Vladi2017/OrCAD_PSpice_1/project_doc/projectDoc_VoltageRegulator_2.pdf

### Cuprins

1. Tema proiectului.

Proiectarea si simularea (OrCAD) unui stabilizator de tensiune cu parametrii Vin = 10 - 15V (amplitudinea variabila a semnalului de intrare); Vout (amplitudinea stabilizata a semnalului de ieșire) = 10V; Ps = 3W (puterea pe rezistenta de sarcina); Precizie = 5%.

1.1. Aspecte specifice.
Din cerințele temei de proiect se observă că avem constrângerea vI,min ≈ vO. Din acest considerent:
- s-a evitat implementarea unei scheme cu element de reglare paralel (datorită căderii de tensiune pe rezistența de balast).
- nu s-a adoptat soluția cu element regulator serie de tip NPN (pe borna + a ieșirii), evitându-se astfel căderea de tensiune BE (care la tranzistoarele de medie putere poate fi 0.75V ÷ 0.9V). Întrucât nu putem avea o cădere nulă de tensiune pe stabilizator (ceea ce ar presupune un randament de 100% al acestuia), pentru domeniul vI,min s-a urmărit încadrarea în precizia de 5% admisă de tema de proiect. Prin urmare se propune schema de stabilizator de tensiune prezentată la pg. 2 fig.1. cu regulator serie de tip PNP.
Ca o primă observație importantă trebuie remarcat că în zona vI,min regulatorul serie PNP va funcționa în regim de saturație unde ne așteptăm la căderi vCE1 de 0.2 ÷ 0.3V, deci aparent ne putem încadra în precizia de 5% [9.5 ÷ 10.5]V.

### Manolescu Vladimir / May 2022 / mvmanol@yahoo.com

2. Prezentarea principiului de funcționare.

Schema OrCAD este prezentată la pg.2 fig.1: Stabilizator liniar cu reacție de tip amplificator de eroare, cu regulator serie.
Tranzistorul Q1 are rol de element regulator serie. Amplificatorul de eroare (de tip transconductanță) este bazat pe tranzistoarele Q3 și Q2. De remarcat că în amplificatorul de eroare s-au folosit 2 tranzistoare NPN astfel încât faza reacției să compenseze efectele ”perturbației” (variația vI respectiv iO) asupra tensiunii de ieșire vO.
Dioda Zener lucrează în zona de străpungere astfel încât vZ are o valoare aproximativ constantă, egală cu tensiunea nominală de străpungere a diodei Vz (parametru de catalog). Rz are rol de polarizare a diodei Zener. Se va alege i[Rz] >> iC2 astfel încât i[Rz] ≈ iZ. Astfel variațiile curentului iC2 nu vor afecta semnificativ vZ.
Cu ajutorul semireglabilului P se va fixa tensiunea la ieșirea stabilizatorului. Pentru a ataca în tensiune intrarea reacției (vB3), curentul prin divizorul rezistiv (iD) trebuie să fie >> iB3.
Funcționarea schemei: pentru tensiunea VO = 10V fixată din semireglabilul P, tranzistorul regulator serie Q1 anulează tendințele de variație ale tensiunii vO atunci când vI sau iO variază. Cum vI = vCE1 + vO, avem:
- când vI crește sau iO scade tendința va fi ca vO să crească. Aceasta implică succesiv: vB3 ↗ => vBE3 ↗ => iC3 ↗ => iB2 ↘ => iC2 ↘ => iB1 ↘ => vCE1 ↗ => vO →. Se observă că regulatorul serie preia tendința de

creștere vO.

- când vI scade sau iO crește tendința va fi ca vO să scadă, cu următoarele consecințe: vB3 ↘ => vBE3 ↘ => iC3 ↘ => iB2 ↗ => iC2 ↗ => iB1 ↗ => vCE1 ↘ => vO →. Se observă din nou că regulatorul serie compensează

tendința de scădere vO pe sarcină.
3. Schema OrCAD (fără protecție la scurtcircuit).

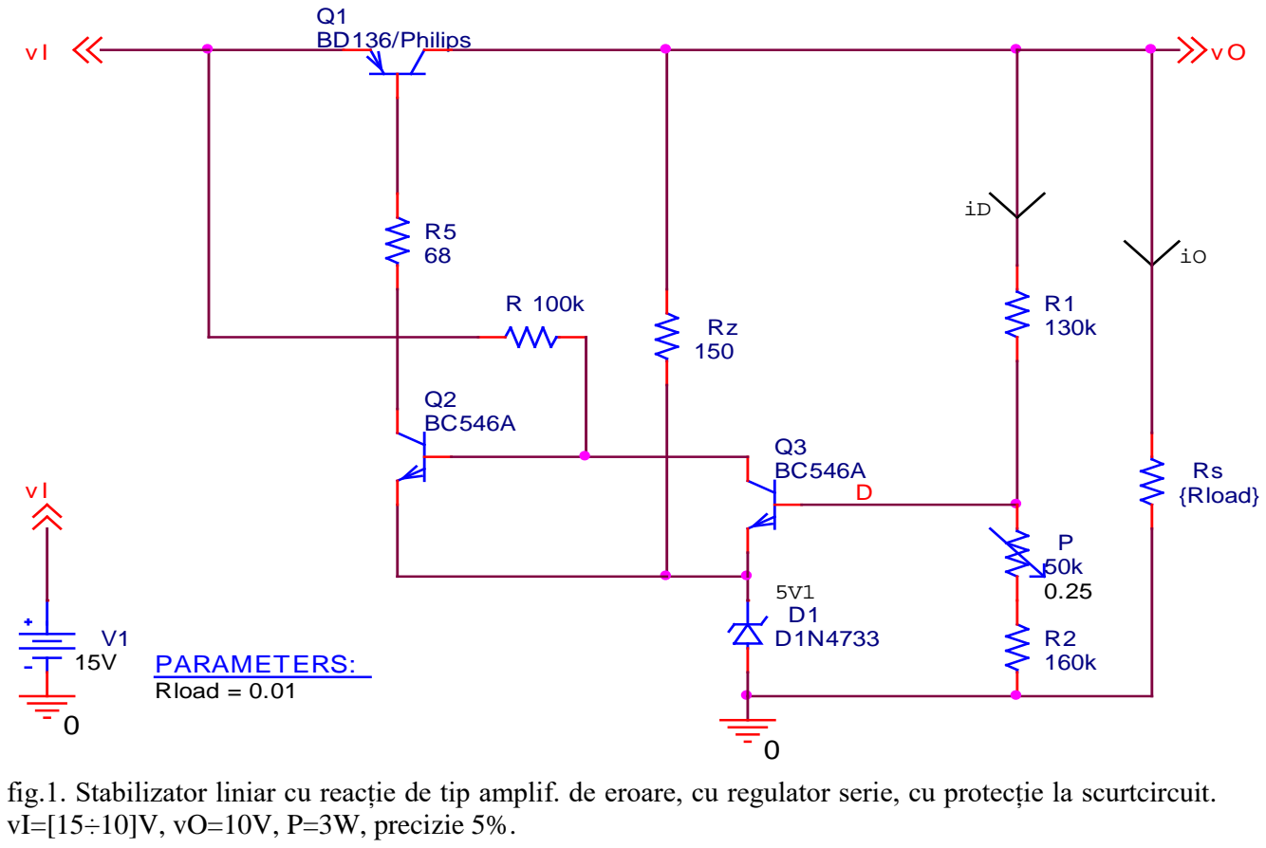
[picture p1: figure]
vI=[15÷10]V, vO=10V, P=3W, precizie 5%.; PARAMETERS:; Rload = 0.01; Rs {Rload}; Q1 BD136/Philips

fig.1. Stabilizator liniar cu reacție de tip amplif. de eroare, cu regulator serie, cu protecție la scurtcircuit.

3.1. Elemente de proiectare.

Din datele de proiect rezultă:

# iO,max = P

vO

= 3
10 => iO,max = 300mA.

vO = VO ± 5% => vO = [9.5 ÷ 10.5]V.
Puterea maximă sustenabilă pe regulatorul Q1 este:

PQ1,max = vCE1,maxiC1,max = vI,max − vO,miniO,max = (15 − 9.5)0.3 = 1.65W.

Se alege ca regulator serie tranzistorul Q1 pnp BD136,cu puterea maximă admisă Pmax = 12.5W și IC1,max = 1.5A. Nu vom impune montarea acestuia pe radiator (admițându-se că va exista o ventilare naturală). Adăugăm următoarele date: β1=50, VBE1=0.8V, β2=200, β3=50 (va lucra cu VCE3 ≈ 0.65V respectiv iC3 de ordinul μA), vBE2 = vBE3 = 0.65V, R5 = 68ohm (stabilizează funcționarea în temperatură).
Determinarea rezistenței R: iR va fi partajat de iB2 și iC2, curenți prin care se asigură mecanismul de reacție pentru stabilizarea tensiunii vO.

# R = vi,min − vBE2 − Vz

iB2
și trebuie să impunem iB2 = iO,max

# β1β2 , => R = vi,min−vBE2−Vz

# iO,max

β1β2 = 10−0.65−5.1

0.3 ∙ 50 ∙ 200 ≈ 140kΩ

Alegem R=100kΩ/250mW, valoare standardizată.
Valoarea Rz a rezistenței de polarizare a diodei Zener: condiția este ca Iz >> iC2 pentru ca dioda Zener să rămână în zona de stabilizare. => IZ ≫ iO,max

# β1 = 5∙iO,max

β1
Rezultă: Rz = vO−Vz

# 5∙iO,max

β1 = 10−5.1

5∙0.3 ∙ 50 = 163Ω.

Se alege valoarea standardizată Rz=150Ω/250mW.
Calculul divizorului rezistiv R1, P, R2: Pentru a obține tensiunea de la intrarea reacției transconductanță, condiția este: iD >> iB3 => iD = 50 ∙ iB3 = 50∙iO,max

# β1β2β3

=>

# R1 + P + R2 = vO

# 50∙iO,max

# β1β2β3 = 10

50∙0.3 ∙ 50 ∙ 200 ∙ 50 ≈ 333kΩ.
Din schemă rezultă: vD = Vz + vBE3 = R2+P

# R1+R2+P

vO

Ca observație, din relația de mai sus rezultă că în condiții normale de funcționare (regulatorul Q1 în

RAN), tensiunea de ieșire vO depinde exclusiv de Vz + vBE3 = constant și de raportul (R1+R2+P)/(R2+P).

Prin urmare putem alege convenabil valorile pe divizorul rezistiv impunând vO = 10V și evident menținând condiția iD >> iB3:

# => R2 + P = (Vz+vBE3)(R1+R2+P)

vO

= (5.1+0.65)∙333k

# 10 => R2 + P ≈ 192kΩ

ð R1 = R1 + P + R2 − P − R2 ≈ 142kΩ. Alegem valoarea standard R1=130kΩ/0.25W.
De asemenea pentru R2 + P ≈ 192kΩ vom avea valorile standard: R2=160kΩ/0.25W și respectiv

semireglabilul P=50kΩ/0.25W.

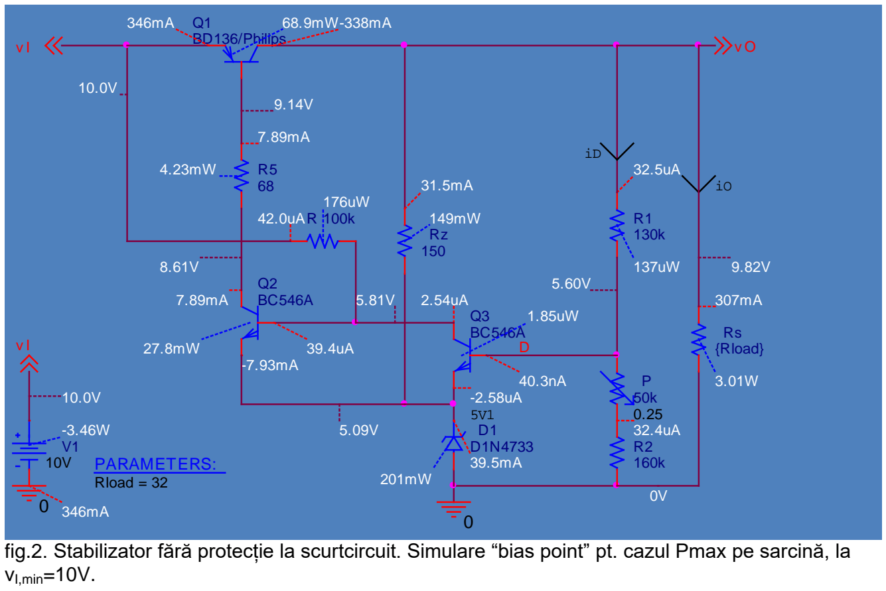
[picture p2: figure]
vI,min=10V.; PARAMETERS: Rload = 32; Q1 BD136/Philips; Rs {Rload}

fig.2. Stabilizator fără protecție la scurtcircuit. Simulare “bias point” pt. cazul Pmax pe sarcină, la

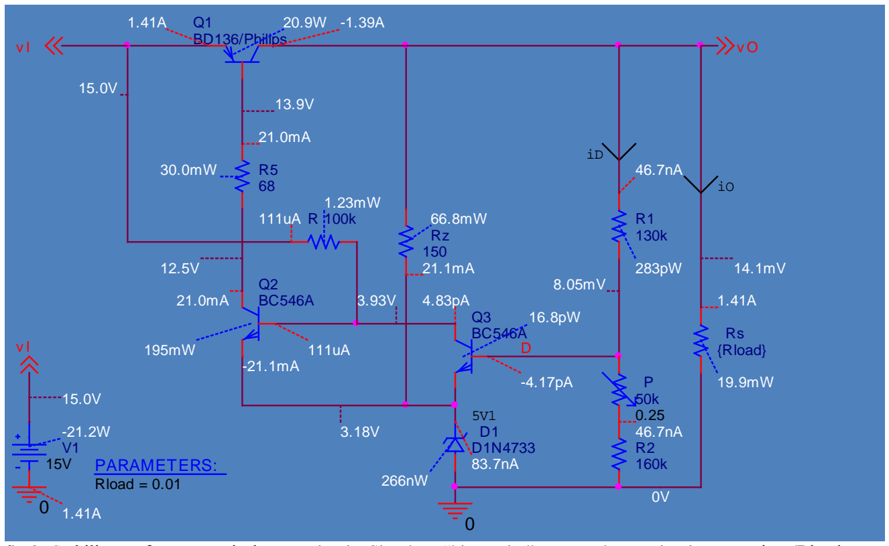
[picture p3: figure]
PARAMETERS: Rload = 0.01; Rs {Rload}; Q1 BD136/Philips

fig.3. Stabilizator fără protecție la scurtcircuit. Simulare “bias point” pt. cazul scurtcircuit pe sarcină (Rload = 0.01), la vI,max=15V. Se observă că întreaga putere este preluată de regulatorul Q1 (cu datele de catalog IcMax = 1.5A, Pmax = 12W), tranzistor care în acest caz se va distruge. Măsurătorile de mai sus (în special puterea pe Q1) se vor compara cu cazul în care schemei i se adaugă protecția la scurtcircuit (a se vedea pg.10, fig.8).

3.2. Performanțe. Aspecte teoretice.
Pentru a evalua performanțele stabilizatorului de tensiune, facem o scurtă prezentare a acestora. Tensiunea de ieșire vO depinde de tensiunea de intrare vI, curentul iO consumat de sarcina Rs și de temperatura de funcționare. Vom studia prin simulare PSpice influența vI și iO asupra vO, deci vom studia funcția vO=vO(vI, iO). Această funcție se poate diferenția și se obține:

# dvO = ∂vO

∂vI

# dvI +

∂vO
∂iO

# diO

În practică, pentru variații vI și iO în domeniul de funcționare normal al stabilizatorului, se poate scrie:

∆vO = 1
S

# ∆vI − Ro∆iO, unde: S ≝ ∆vI

∆vO

|∆iO = 0 este coeficientul de stabilizare.

# Ro ≝ ∆vO

−∆iO

|∆vI = 0 este rezistența de ieșire.

Se poate defini și un coeficient de stabilizare în sarcină pentru un RL de valoare finită. Astfel, în schema echivalentă de semnal mic a stabilizatorului de tensiune, curentul de ieșire iO va fi nenul și va depinde de RL. Conform fig.4 de mai jos se obține:

# vo = RL RL + Ro

∙

vI
S

Notând factorul de stabilizare în sarcină cu K, rezultă:

K ≝

vI
vO

# |RL = finit = (1 +

Ro
RL

) ∙ S.

Se observă că pentru RL → ∞, se obține K = S. Un stabilizator de tensiune performant are rezistența de ieșire Ro foarte mică, astfel încât Ro << RL, caz în care K ≈ S.

fig.4

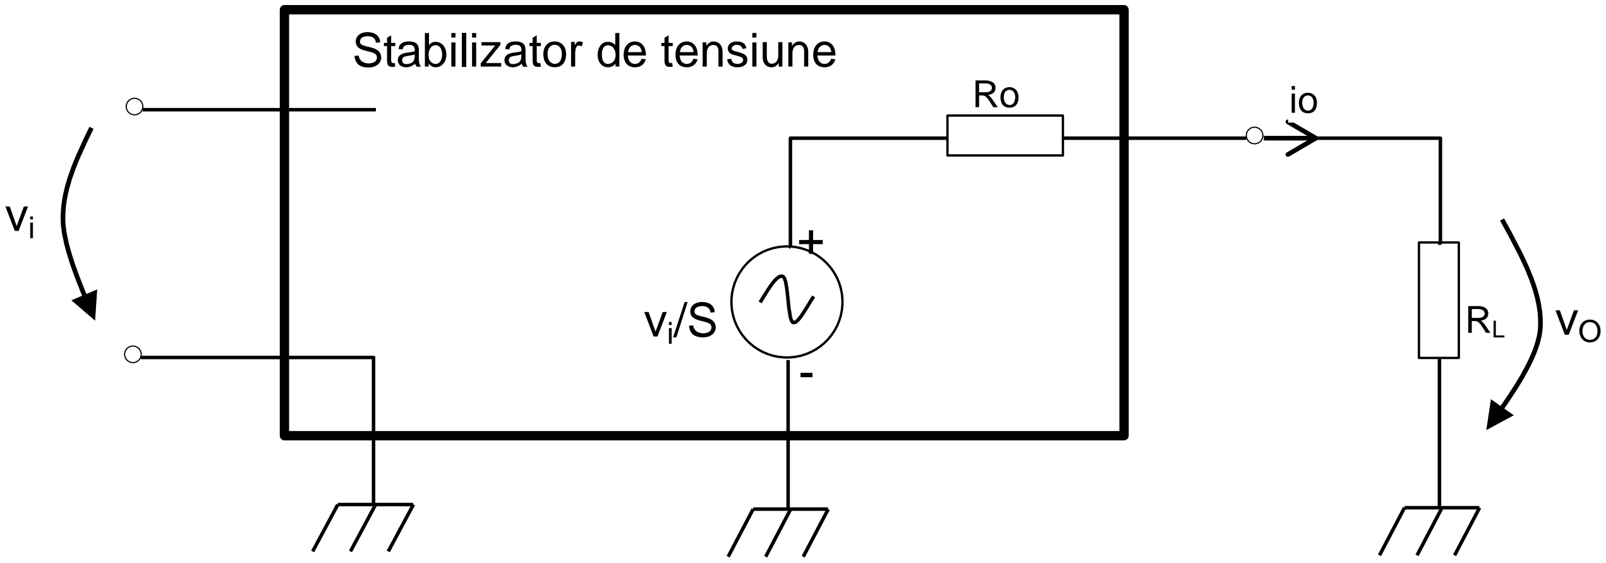
[picture p4: figure]
Stabilizator de tensiune

În continuare vom face un studiu PSpice al parametrilor de performanță S și Ro, respectiv variația acestora în domeniul temei de proiect: vI=[10 ÷ 15]V, respectiv Po=[1 ÷ 3]W ce corespunde unui curent de ieșire iO=[0.1 ÷ 0.3]A.
Pentru studiul S și Ro se va folosi funcția PSpice D(x) – (numerical) derivative.

3.3. Coeficientul de stabilizare (simulare PSpice).
Pentru schema din fig.1, variația coeficientului de stabilizare K (în sarcină) funcție de vI este prezentată la pg. 7, fig.5, împreună cu alte elemente relevante (tensiunea și puterea pe sarcină).

Observație: se poate pune întrebarea de ce factorul de stabilizare K nu este constant, întrebare de altfel plauzibilă și pentru cazul rezistențelor de ieșire Ro (tratate în paragraful 5). Explicația este aceea că în graficele următoare nu se fac analize de semnal mic. Așa cum se precizează mai sus, pentru K avem variații vI pe intrare de 5V, respectiv pentru Ro avem o variație de curent prin sarcină de cca. 200mA. Practic stabilizatorul (prin analize de tip DC-sweep) este tranzitat prin puncte statice de funcționare succesive unde sunt calculate derivatele numerice pentru aproximarea K respectiv Ro. Analiza se face în întreg domeniul solicitat de tema de proiect.

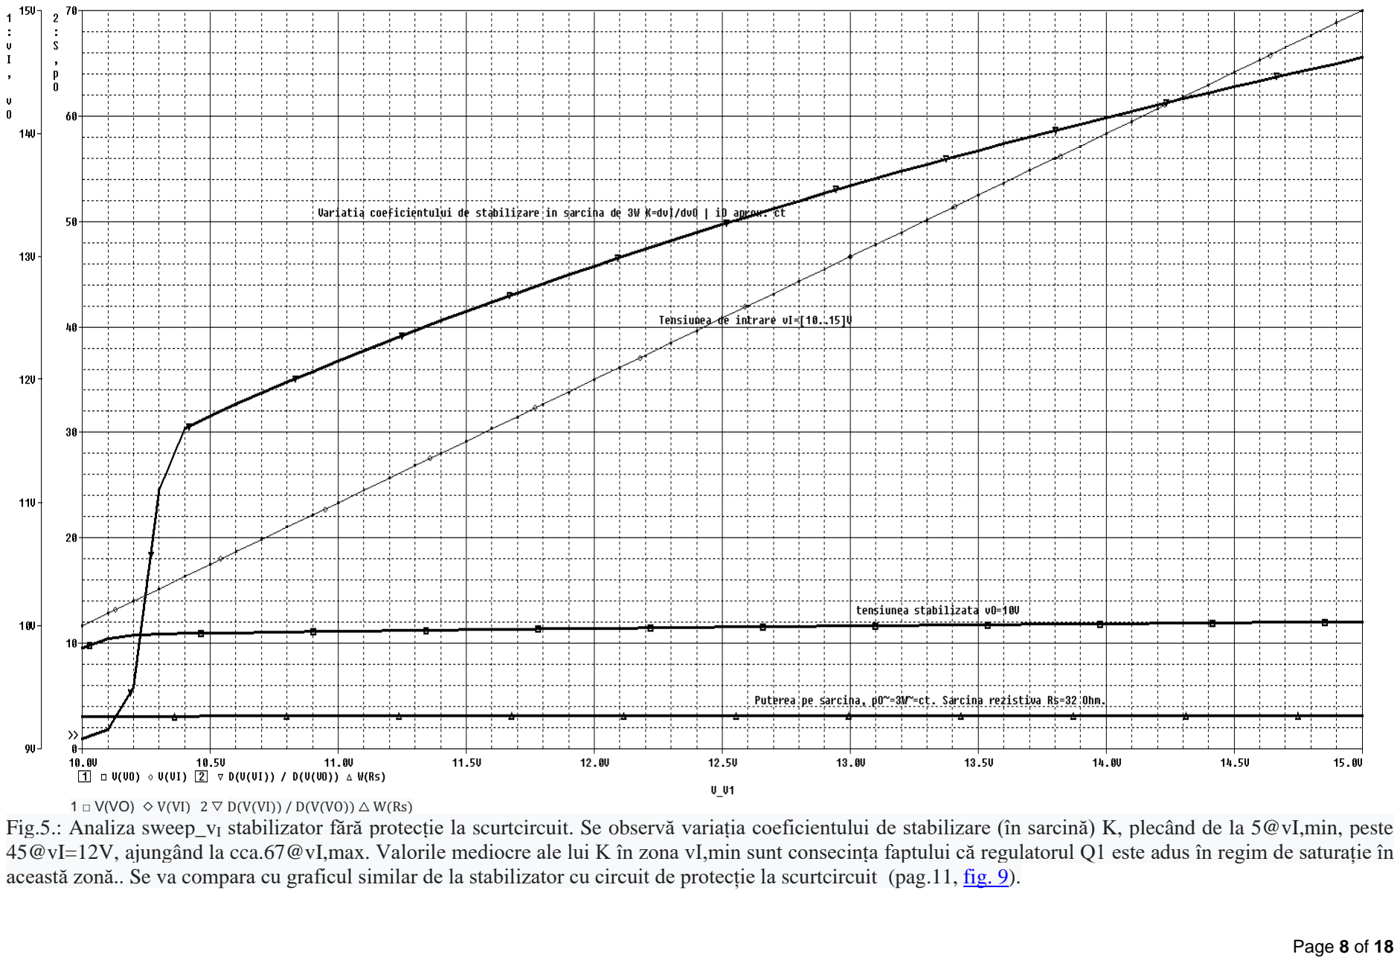
[picture p5: page 7]

# 1 □ V(VO) ◇ V(VI) 2 ▽ D(V(VI)) / D(V(VO)) △ W(Rs)

Fig.5.: Analiza sweep_vI stabilizator fără protecție la scurtcircuit. Se observă variația coeficientului de stabilizare (în sarcină) K, plecând de la 5@vI,min, peste 45@vI=12V, ajungând la cca.67@vI,max. Valorile mediocre ale lui K în zona vI,min sunt consecința faptului că regulatorul Q1 este adus în regim de saturație în această zonă.. Se va compara cu graficul similar de la stabilizator cu circuit de protecție la scurtcircuit (pag.11, fig. 9).

4. Schema OrCAd cu protecție la scurtcircuit.

Aceasta este prezentată în fig. 6 de mai jos și, după cum se observă, prezintă anumite elemente distinctive:
a. ”senzorul” de scurtcircuit (R6) este plasat înainte de regulatorul serie (uzual acesta este plasat după regulator). În acest mod, R6 (combinat și cu valoarea redusă a rezistenței acestuia) are o influență mai redusă asupra rezistenței de ieșire Ro a stabilizatorului.
b. căderea de tensiune pe R6 este ”citită” de o combinație de tranzistoare în configurație Darlington.
c. circuitul de protecție nu mai atacă (direct) baza regulatorului serie (metoda uzuală), ci atacă intrarea amplificatorului de eroare, speculând amplificarea acestuia. S-a introdus R7 astfel încât traseul să nu fie compus din secțiuni exclusiv semiconductoare.
Combinația elementelor prezentate mai sus ne permite să micșorăm valoarea rezistenței R6 fără a compromite funcționalitatea montajului. O rezistență R6 de valoare cât mai mică are efect benefic asupra impedanței de ieșire Ro cât și (în cazul nostru particular) asupra coeficientului de stabilizare în zona vI,min. Deși nu se exploatează întreg potențialul configurației Darlington (întrucât prin circuitul de protecție avem curenți de valoare foarte mică), totuși protecția se activează la o cădere de tensiune de cca. 0.4V pe R6. Dezavantajul schemei de protecție prezentate este că nu permite LED indicator de scurtcircuit (suprasarcină), curentul maxim iC5 fiind de cca. 19uA.

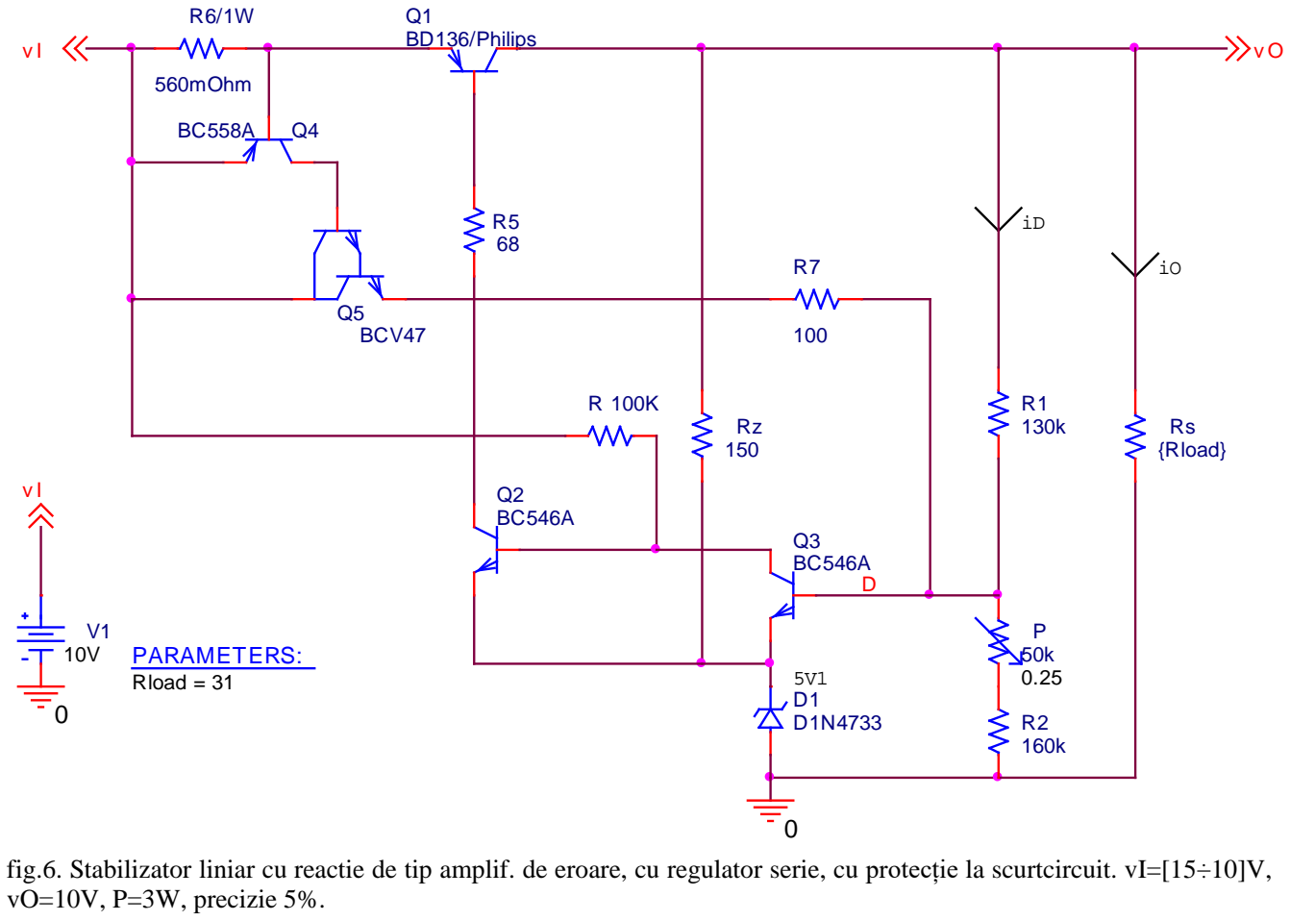
[picture p6: figure]
vO=10V, P=3W, precizie 5%.; PARAMETERS: Rload = 31; Q1 BD136/Philips vI; 560mOhm; Q5 BCV47; Rs {Rload}

fig.6. Stabilizator liniar cu reactie de tip amplif. de eroare, cu regulator serie, cu protecție la scurtcircuit. vI=[15÷10]V,

4.1. Principiul de funcționare al circuitului de protecție.
La activare (atingerea unui curent iC1 de cca 650mA), circuitul de protecție ”trage în sus” potențialul vB3, consecința finală fiind reducerea iB1 și respectiv limitarea iC1. Reacția de amplificare transconductanță este practic atacată în tensiune, curentul iC5,max fiind de cca. 19uA (a se vedea fig.8).

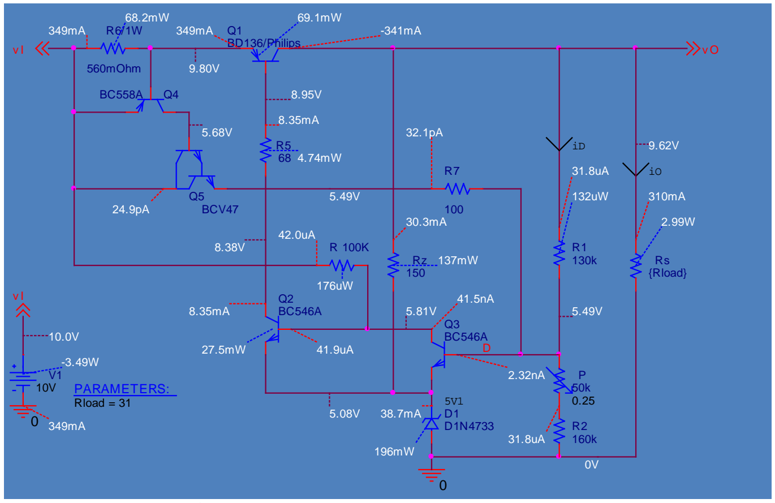
[picture p7: figure]
Q1 BD136/Philips; PARAMETERS: Rload = 31; BCV47; Rs {Rload}; 560mOhm

Fig.7. Stabilizator cu protecție la scurtcircuit. Simulare “bias point” pt. cazul Pmax pe sarcină.
Comparativ cu schema fără protecție (fig.2, pag.4) observăm o degradare cu 180mV (-1.84%) a tensiunii stabilizate, diferența regăsită pe rezistența de detecție scurtcircuit R6/1W. De asemenea remarcăm că pt. vI,min=10V, Q3 este practic blocat, curentul partajabil iR fiind preluat în totalitate pe iB2.

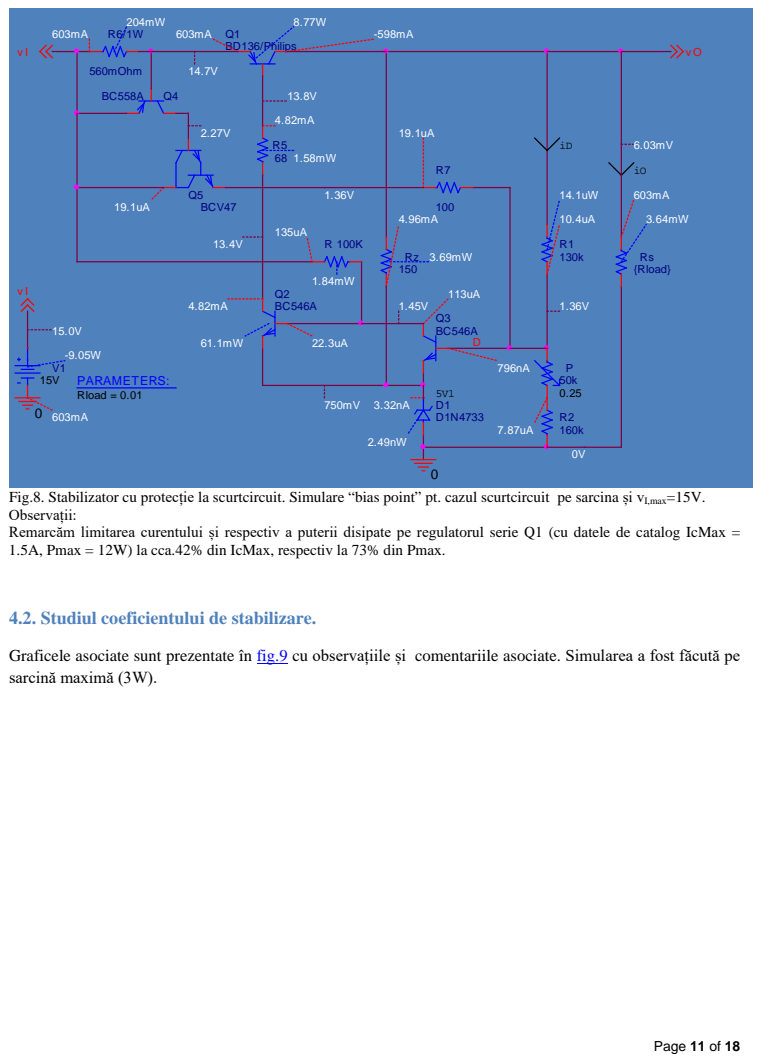
[picture p8: page 10]

Fig.8. Stabilizator cu protecție la scurtcircuit. Simulare “bias point” pt. cazul scurtcircuit pe sarcina și vI,max=15V.
Observații:
Remarcăm limitarea curentului și respectiv a puterii disipate pe regulatorul serie Q1 (cu datele de catalog IcMax =
1.5A, Pmax = 12W) la cca.42% din IcMax, respectiv la 73% din Pmax.

4.2. Studiul coeficientului de stabilizare.
Graficele asociate sunt prezentate în fig.9 cu observațiile și comentariile asociate. Simularea a fost făcută pe
sarcină maximă (3W).

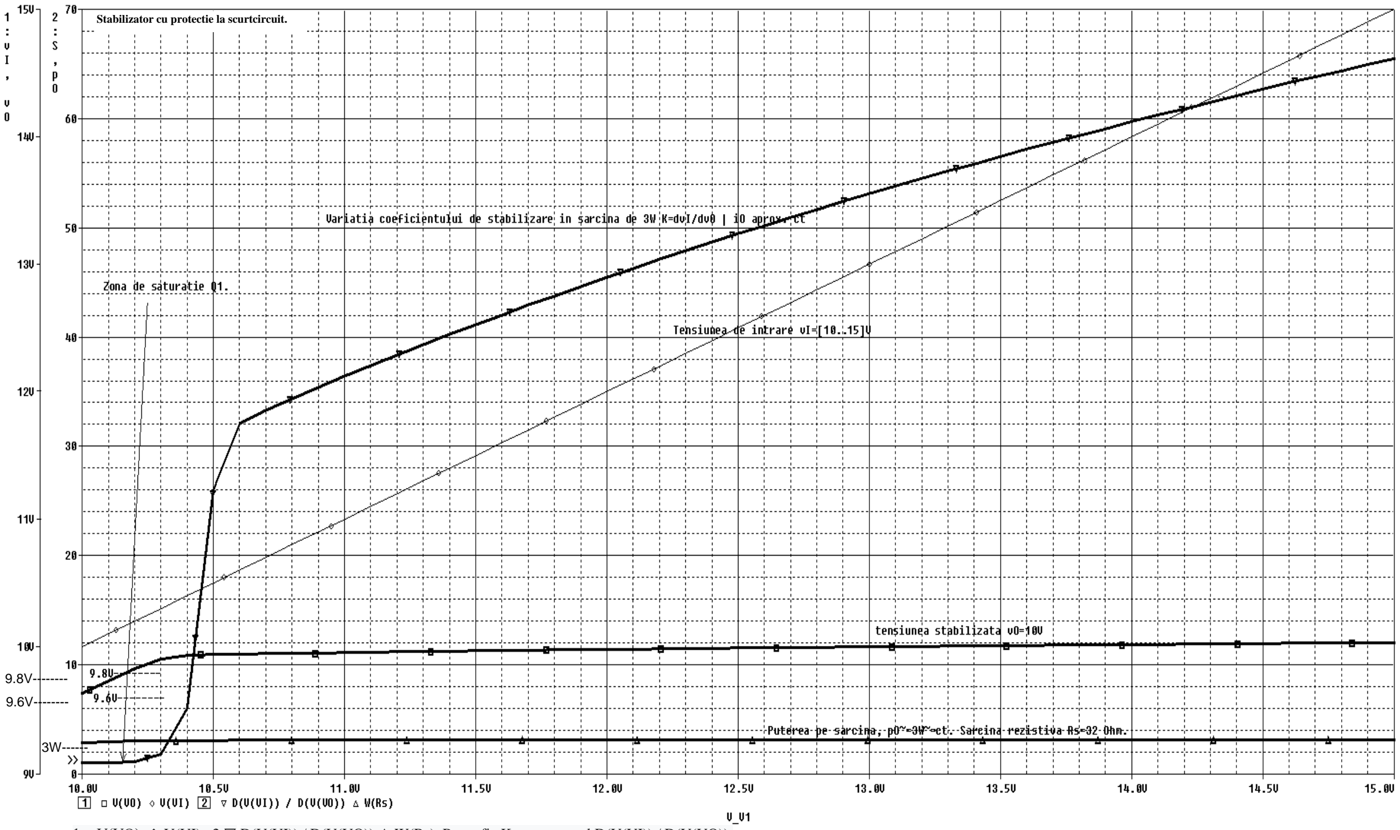
[picture p9: figure]

1 □ V(VO) ◇ V(VI) 2 ▽ D(V(VI)) / D(V(VO)) △ W(Rs). Pe grafic K este raportul D(V(VI)) / D(V(VO)).
Fig.9.: Analiza sweep_vI stabilizator cu circuit de protecție la sc. Se obs. degradarea pronunțată a coeficientului de stabilizare în sarcină (maximă). Avem K < 2 în zona vI,min, comparativ cu varianta fără circuit de protecție la sc (comparație cu graficul fig.5, pag.7). Practic zona de saturație Q1 se prelungește cu cca. 200mV, consecința influenței “senzorului” de sc R6. Cu alte cuvinte stabilizarea este relativ precară în zona vI,min [10..10.3]V, acesta fiind (parțial) prețul plătit pt. a avea protecție la scurtcircuit. R6 accentuează influența zonei de saturație a regulatorului Q1. În consecință deducem că “senzorul” R6 nu ar avea o influență semnificativă asupra lui K (coeficientului de stabilizare în sarcină) dacă stabilizatorul ar lucra cu vO < vI,min (aspect reliefat si de creșterea semnificativă a lui K după zona vI=10.4V). Pe de altă parte acest aspect (micșorarea zonei de saturație Q1) justifică soluția de protecție la scurtcircuit (configurație Darlington cu atacarea circuitului de reacție), aleasă tocmai în idea de a reduce cât mi mult valoarea ”senzorului” de suprasarcină R6.

Stabilizator cu protectie la scurtcircuit.

5. Grafice rezistențe de ieșire. Comparații.

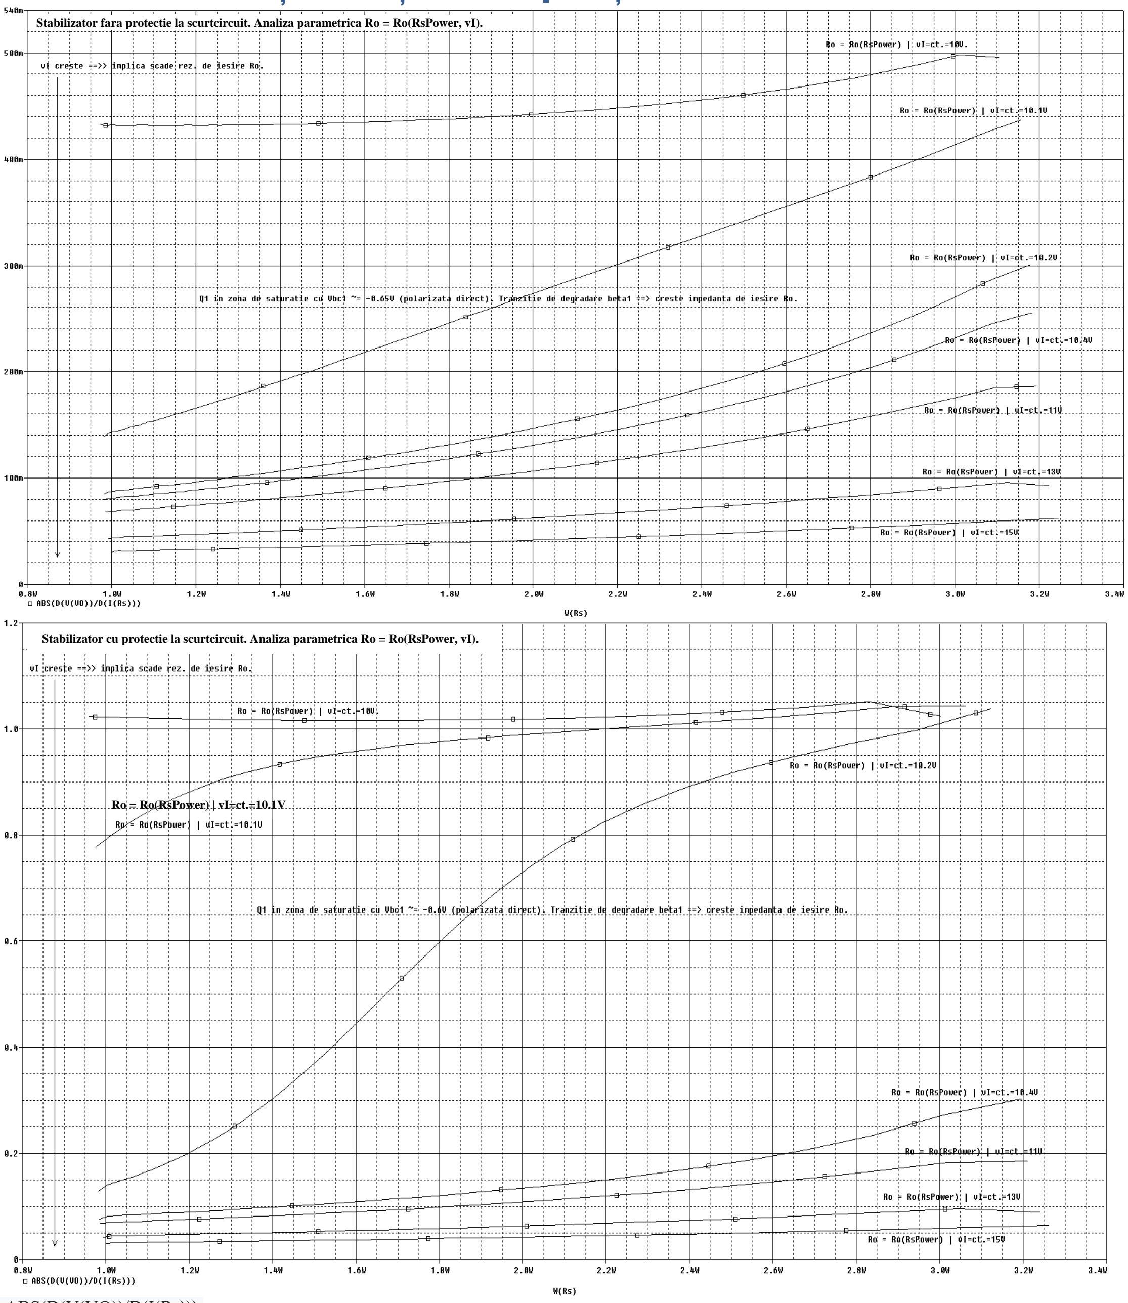
[picture p10: figure]
Ro = Ro(RsPower) | vI=ct.=10.1V

□ ABS(D(V(VO))/D(I(Rs))).
fig.10. Impedanțe de ieșire (Ro) – comparație pt. stabilizator fără / cu circuit de protecție la scurtcircuit. Se observă degradarea rezistenței de ieșire Ro comparativ cu cazul fără protecție la sc pt. cazul Q1 în zona de saturație (degradarea Ro este de la cca. 500mOhm la cca. 1.05 Ohm). Pt. cazul Q1 RAN degradarea Ro este mult mai redusă datorită configurației Q1 de bază comună cu ieșire din colector (”senzorul” de sc R6 fiind în emitor), cu valori cuprinse între 100mOhm ÷ 200mOhm. De asemenea observăm că pe măsură ce ne depărtăm de saturația Q1 (crește ecartul vi – vO, (deci crește vCE1), Ro scade și tinde să devină constantă în plaja de curent pe sarcină.

Stabilizator cu protectie la scurtcircuit. Analiza parametrica Ro = Ro(RsPower, vI).

Stabilizator fara protectie la scurtcircuit. Analiza parametrica Ro = Ro(RsPower, vI).

5.1. Analiza tensiunii stabilizate funcție de curentul prin sarcină. Aceasta este prezentată în fig.11 pentru cazul cu circuit de protecție la suprasarcină.

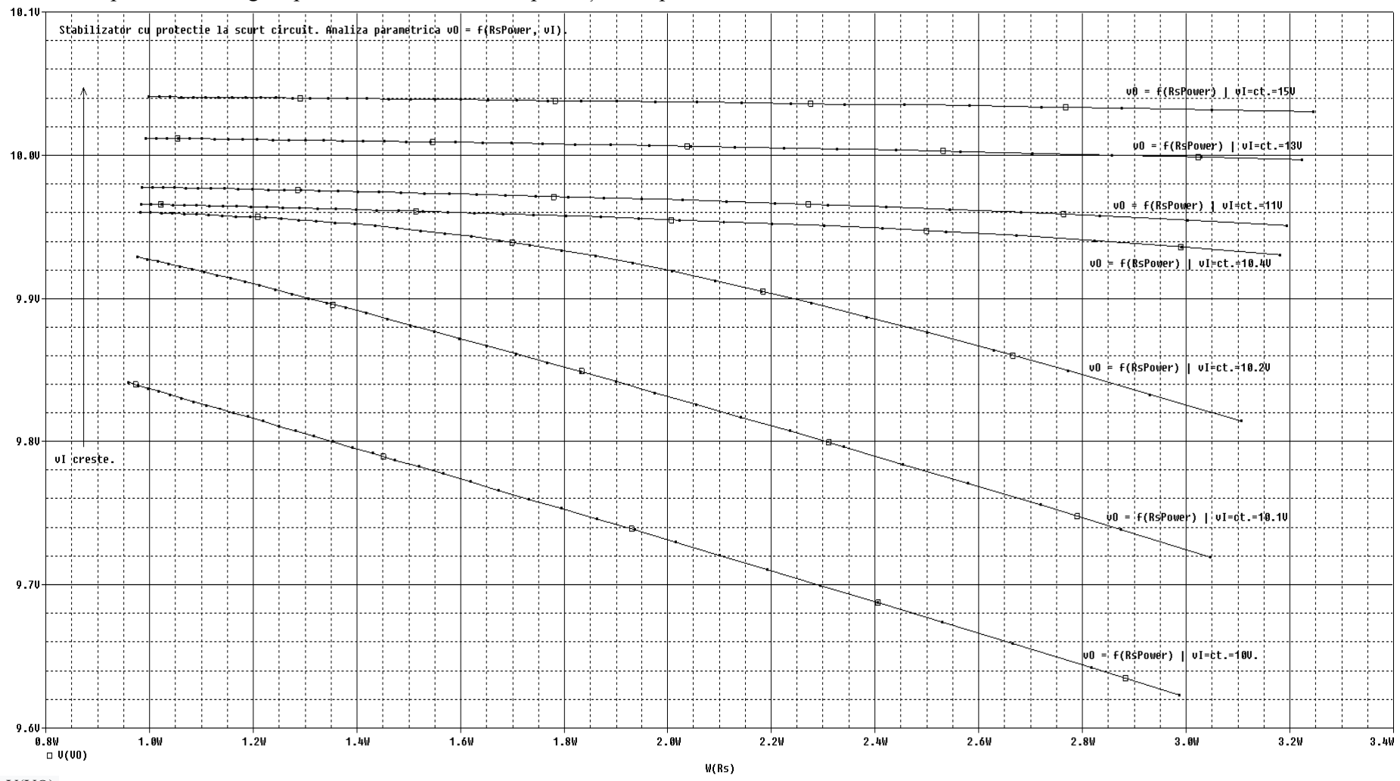
[picture p11: figure]

□ V(VO).
fig. 11. Arată consecințele rezistenței de ieșire Ro asupra vO și dependența Ro de vI. Ro scade (se îmbunătățește) cu cât crește ecartul vI-vO, permițând astfel regulatorului Q1 să lucreze în regiunea activă normală (RAN). Observație: din grafic, variațiile tensiunii stabilizate vO pot părea exagerate și aparent sursa nu ar stabiliza în sarcină. Cu toate acestea, dacă facem un calcul simplu, din grafic rezultă de ex. pt. cazul vI=10V≈vO (cazul cel mai defavorabil), că la o creștere a puterii pe sarcină cu 200% (de la 1W la 3W) avem o variație a tensiunii de ieșire vO de -2.23% (variație datorată evident rezistenței de ieșire Ro a sursei de tensiune).

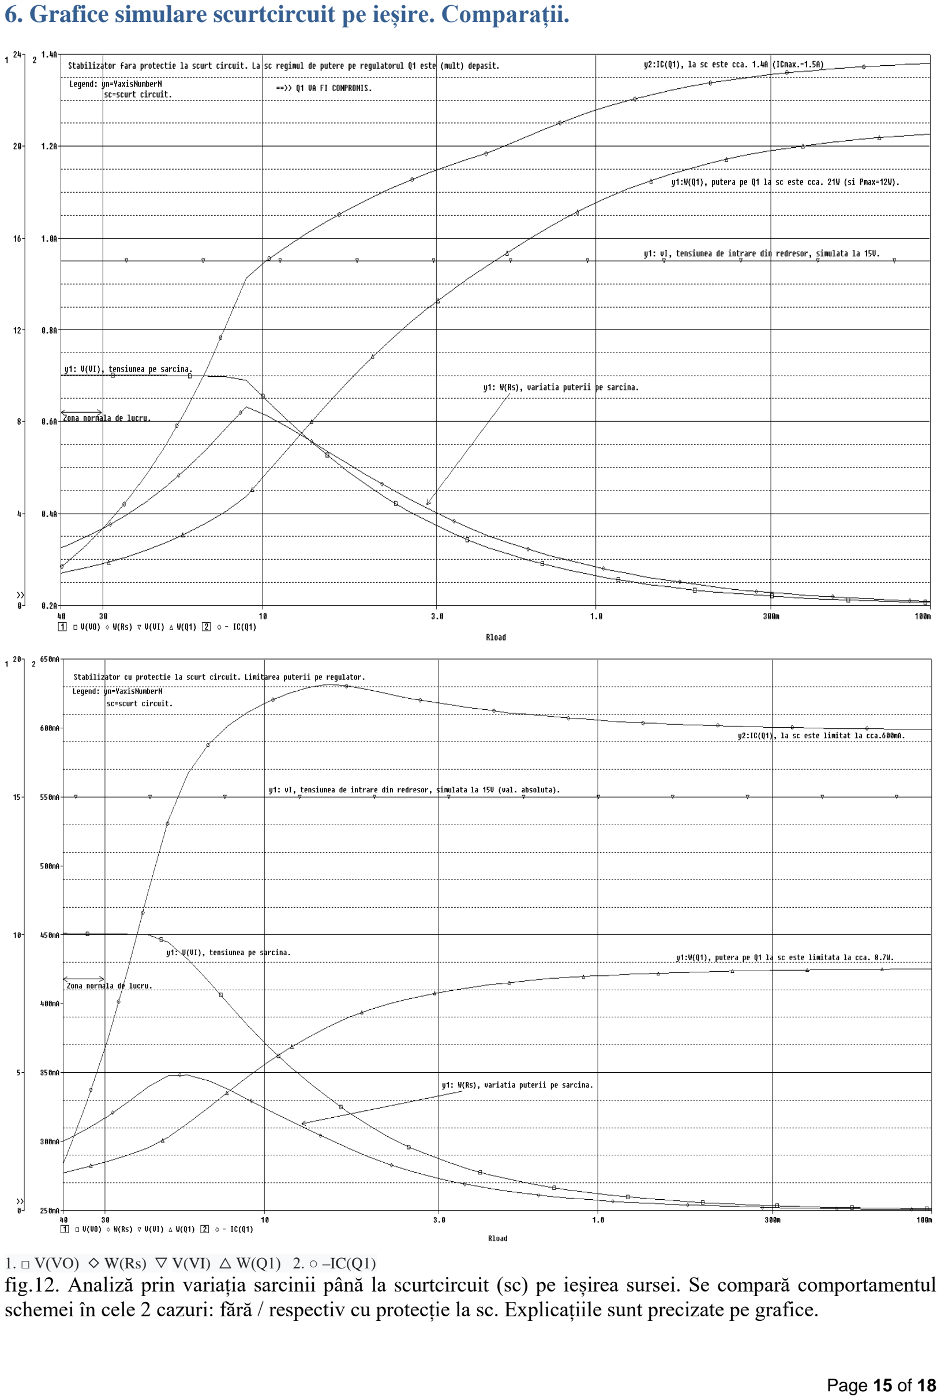
[picture p12: page 14]

6. Grafice simulare scurtcircuit pe ieșire. Comparații.
1. □ V(VO) ◇ W(Rs) ▽ V(VI) △ W(Q1) 2. ○ –IC(Q1)

fig.12. Analiză prin variația sarcinii până la scurtcircuit (sc) pe ieșirea sursei. Se compară comportamentul schemei în cele 2 cazuri: fără / respectiv cu protecție la sc. Explicațiile sunt precizate pe grafice.

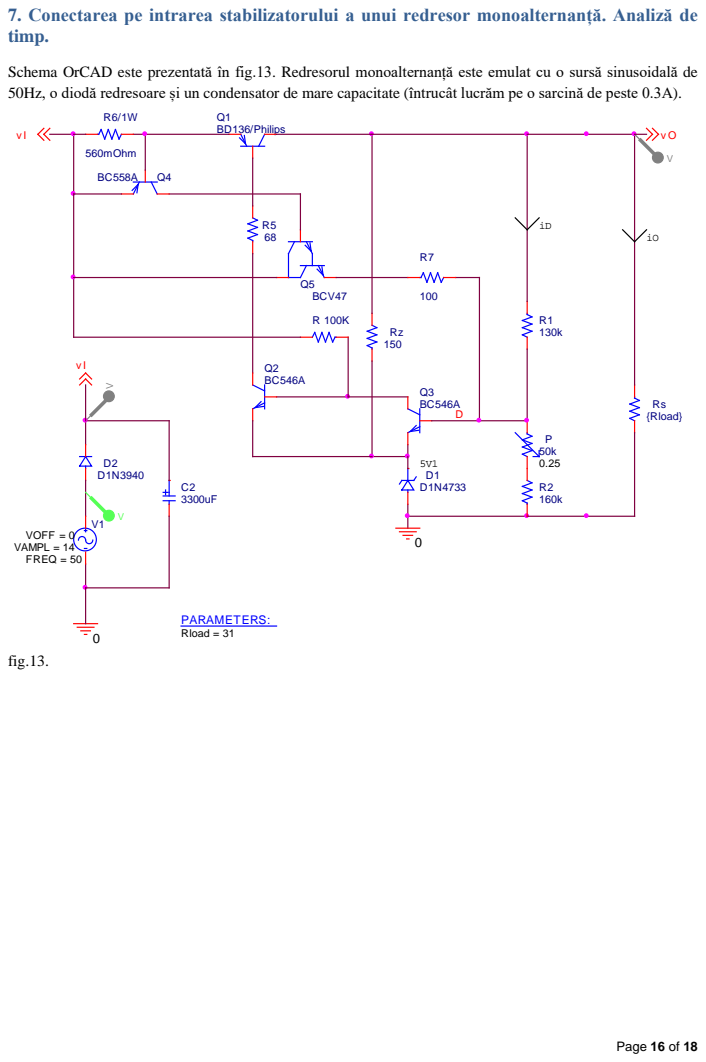
[picture p13: page 15]

7. Conectarea pe intrarea stabilizatorului a unui redresor monoalternanță. Analiză de
timp.
Schema OrCAD este prezentată în fig.13. Redresorul monoalternanță este emulat cu o sursă sinusoidală de
50Hz, o diodă redresoare și un condensator de mare capacitate (întrucât lucrăm pe o sarcină de peste 0.3A).

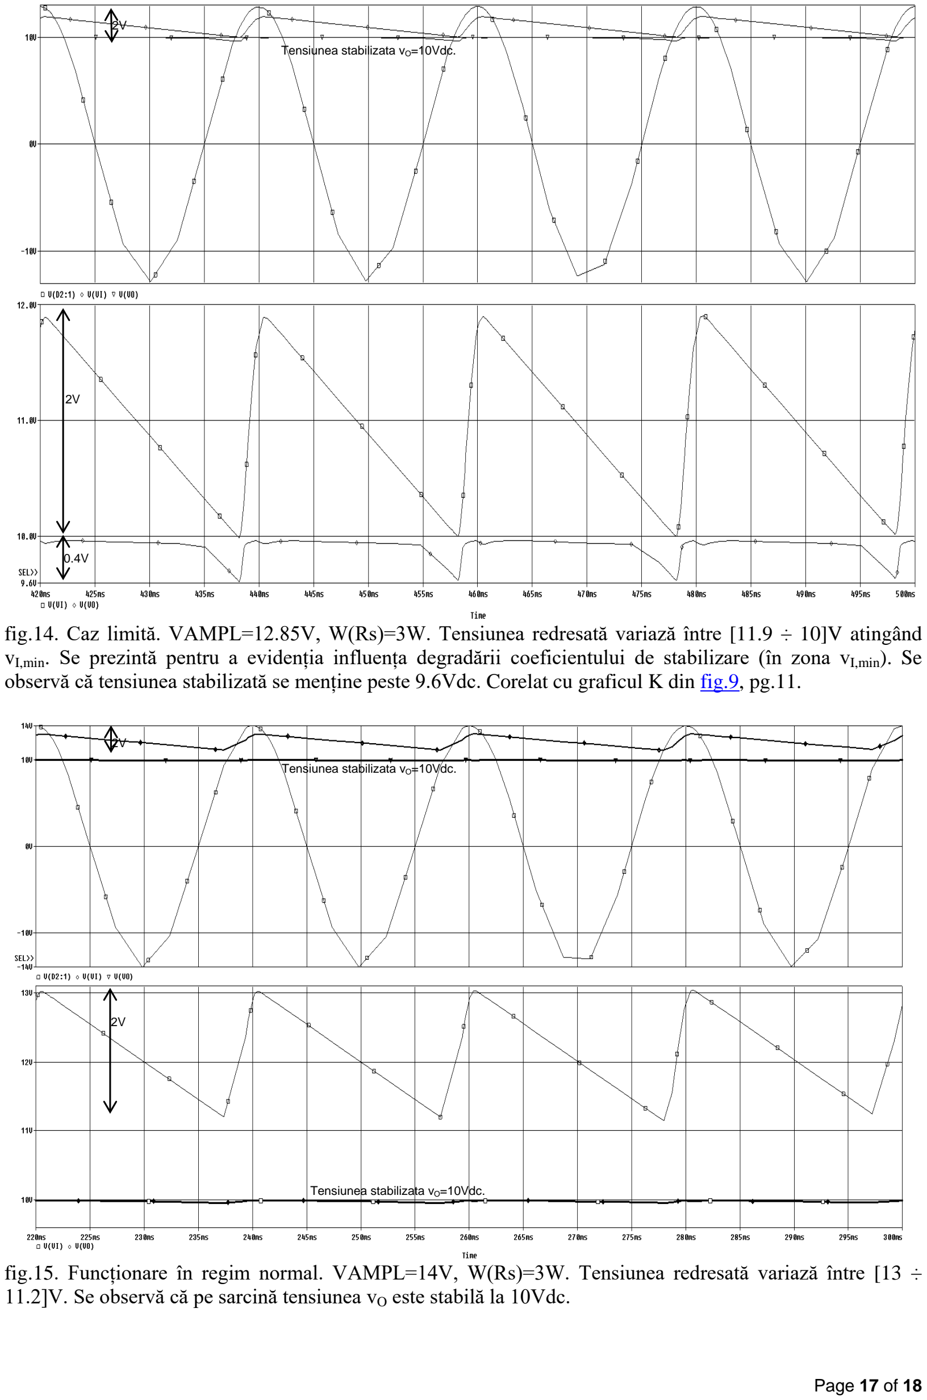
[picture p14: page 16]

fig.14. Caz limită. VAMPL=12.85V, W(Rs)=3W. Tensiunea redresată variază între [11.9 ÷ 10]V atingând vI,min. Se prezintă pentru a evidenția influența degradării coeficientului de stabilizare (în zona vI,min). Se observă că tensiunea stabilizată se menține peste 9.6Vdc. Corelat cu graficul K din fig.9, pg.11.

fig.15. Funcționare în regim normal. VAMPL=14V, W(Rs)=3W. Tensiunea redresată variază între [13 ÷ 11.2]V. Se observă că pe sarcină tensiunea vO este stabilă la 10Vdc.

Tensiunea stabilizata vO=10Vdc.

Tensiunea stabilizata vO=10Vdc.

2V

2V

0.4V

2V

2V
Tensiunea stabilizata vO=10Vdc.

8. Concluzii.

Stabilizatorul de tensiune proiectat îndeplinește cerințele temei de proiectare.
Stabilizatorul nu are parametrii de performanță satisfăcători pe zona inferioară a domeniului tensiunii de intrare solicitat prin tema de proiectare. În particular factorul de stabilizare este sub 6 pentru vI < 10.2V (vI < 10.4V cu protecție). Ro este între [300 ÷ 500]mOhm vI < 10.2V ([300mOhm ÷ 1.05ohm] pentru vI<10.4V cu protecție la suprasarcină). Totuși trebuie precizat că alte soluții practic nu s-ar fi încadrat în cerințele temei de proiectare. Stabilizatorul prezintă performanțe bune pentru tensiuni de intrare vI > 10.5V cu factorul de stabilizare în sarcină maximă K în intervalul [30 ÷ 66], respectiv Ro cca. [180mOhm ÷ 50mOhm]. Performanțele se îmbunătățesc pe măsură ce crește ecartul vI – vO permițând regulatorului Q1 depărtarea de zona de saturație.
9. Lista de componente.

Nr.
crt.
Codificare | Descriere
Stabilizator fără protecție la suprasarcină.
1. 1 x Circuit imprimat.
2. | 1 x BD136 (https://www.tme.eu/ro/details/bd136/tranzistori-tht-pnp/stmicroelectronics/) | Tranzistor: PNP; 45V; 1,5A; 12W; SOT32, Philips
3. | 1 x 1N4733A (https://www.tme.eu/ro/details/1n4733a/diode-zener-tht/onsemi/) | Diodă: Zener; PD=1W; Vz@Izt=5,1V; Izt=49mA, DO41; 10uA, Izk=1mA; Producator: ONSEMI
4. | 2 x BC546A (https://www.tme.eu/ro/details/bc546a/tranzistori-tht-npn/semtech-electronics-limited/bc546a-bulk/) | Tranzistor: NPN; 65V; 0,1A; 500mW; TO92;SEMTECH ELECTRONICS LIMITED
5. Rezistențe standard:
6. 1 x 68/0.25W
7. 1 x 150/0.25W
8. 1 x 100k/0.25W
9. 1 x 130k/0.25W
10. 1 x 160k/0.25W
11. | 1 x 50k/0.25W | semireglabil
Stabilizator cu protecție la suprasarcină.
12. | 1 x BC558A | PNP, uz general.
13. | 1 x BC107BP | NPN, uz general, Zetex.
14. | 1 x BCV47 | NPN; bipolar; Darlington; 60V; 0,5A; 250mW; SOT23; Producator: NEXPERIA
15. | 1 x 100/0.25W | Rezistență standard
16. | 1 x 560mOhm/1W | Rezistență standard
10. Bibliografie.
1. Ștefan SIMION, Introducere în analiza și proiectarea circuitelor electronice fundamentale, Academia Tehnică Militară București, ISBN: 978-606-25-0645-2
2. Ștefan Simion, Iosif Prasoveanu, Doru Jipa, „Dispozitive și circuite electronice”, Editura Academiei Tehnice Militare, 2000
