Vladi2017/OrCAD_PSpice_1/plots/stab1-DC_Sweep.png

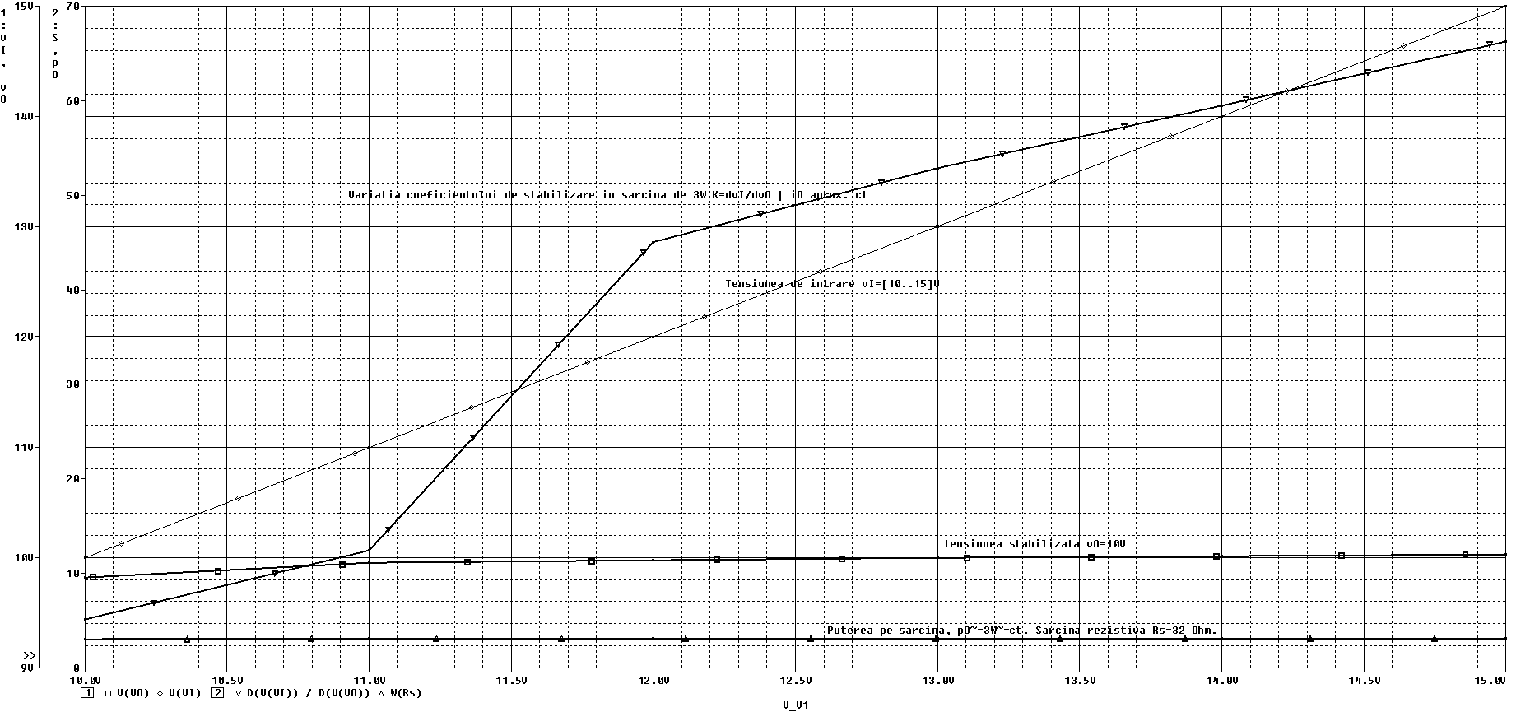
plots/stab1-DC_Sweep.png
