Vladi2017/OrCAD_PSpice_1/plots/stab2Prot2-DC_Sweep_vI.png

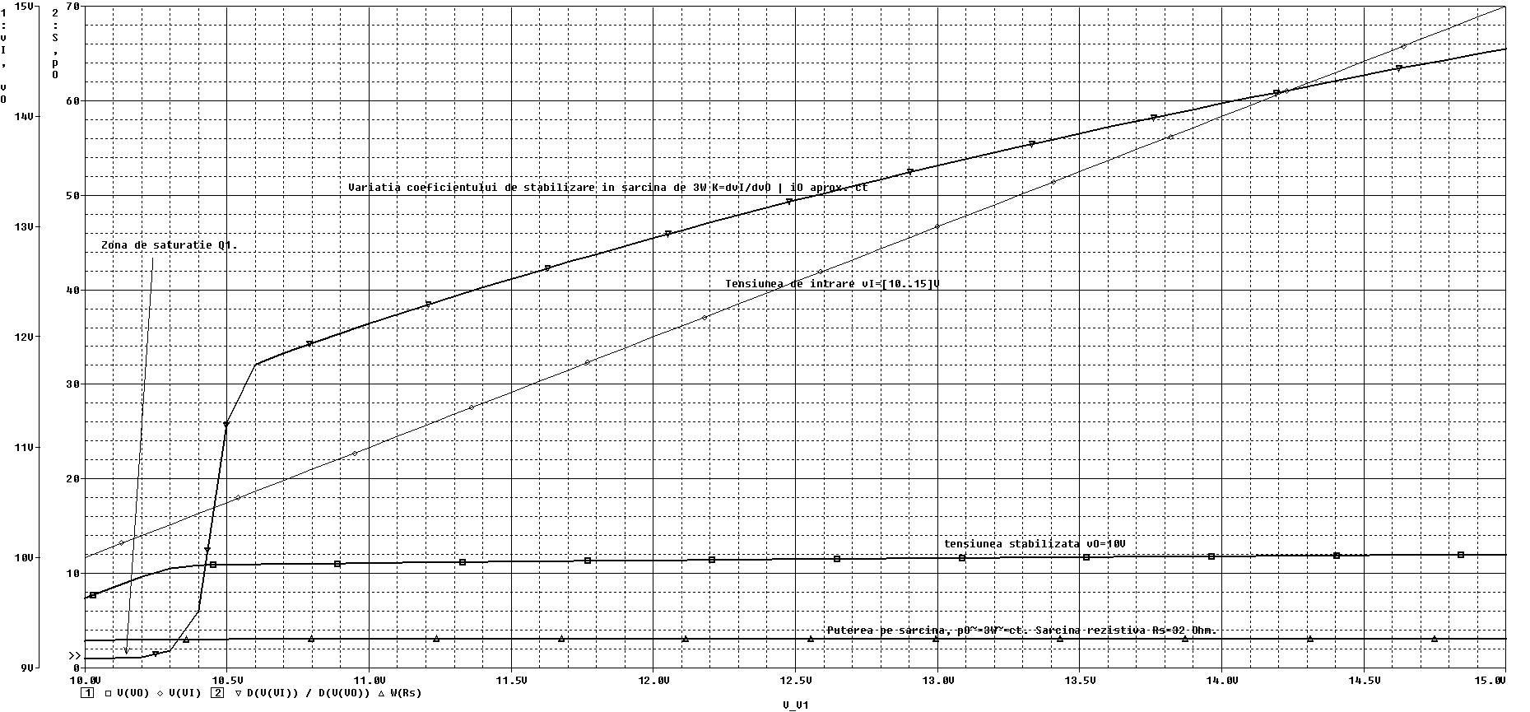
plots/stab2Prot2-DC_Sweep_vI.png
