Vladi2017/OrCAD_PSpice_1/stab_v1-stab1-parametric1.sim.cir

** Profile: "stab1-parametric1"  [ C:\Users\mvman\projects2\OrCAD\AnaSim\stabilizTensiune\stab_v1-stab1-parametric1.sim ] 

** Creating circuit file "stab_v1-stab1-parametric1.sim.cir" 
** WARNING: THIS AUTOMATICALLY GENERATED FILE MAY BE OVERWRITTEN BY SUBSEQUENT SIMULATIONS

*Libraries: 
* Local Libraries :
* From [PSPICE NETLIST] section of C:\Orcad\PSpice\PSpice.ini file:
.lib "nom.lib" 

*Analysis directives: 
.DC LIN V_V1 10 15 1 
.STEP LIN PARAM Rload 40 10 -10 
.PROBE V(*) I(*) W(*) D(*) NOISE(*) 
.INC ".\stab_v1-stab1.net" 


.END
