Vladi2017/OrCAD_PSpice_1/stab_v1-stab1-sweepRs-sc.sim.cir

** Profile: "stab1-sweepRs-sc"  [ C:\Users\mvman\projects2\OrCAD\AnaSim\stabilizTensiune\stab_v1-stab1-sweepRs-sc.sim ] 

** Creating circuit file "stab_v1-stab1-sweepRs-sc.sim.cir" 
** WARNING: THIS AUTOMATICALLY GENERATED FILE MAY BE OVERWRITTEN BY SUBSEQUENT SIMULATIONS

*Libraries: 
* Local Libraries :
* From [PSPICE NETLIST] section of C:\Orcad\PSpice\PSpice.ini file:
.lib "nom.lib" 

*Analysis directives: 
.DC OCT PARAM Rload 0.1 40 5 
.PROBE V(*) I(*) W(*) D(*) NOISE(*) 
.INC ".\stab_v1-stab1.net" 


.END
