Vladi2017/OrCAD_PSpice_1/(list of files, drawings)

Other design files:
STAB_V1.DSN
stab_v1.opj
